DanielVorhaug/TFE4152-Project--Digital-Pixel-Sensor/README.md

TFE4152-Project: Digital Pixel Sensor

A 10bit, 100x100 pixel camera sensor. With the pixel designed in SPICE and the pixel array and supporting logic designed in SystemVerilog.

See https://github.com/wulffern/dic2021/blob/main/lectures/l6_project.md for background.
