DanielVorhaug/TFE4152-Project--Digital-Pixel-Sensor/IC_project.pdf

# A 10bit, 100×100 pixel Photosensor

Carl Thyness, Student, NTNU and Daniel Vorhaug, Student, NTNU

Abstract—A 10-bit 100×100p photosensor is described. The design consisting of two parts that are simulated seperately. One part being a single pixel with a 10-bit digital-output, simulated in SPICE. The other being the digital system, including the array of pixels, all the necessary logic for correct timings, proper readout and control of the analog part. The digital part is simulated using SystemVerilog, and is scalable to any resoulution, bit depth and output bus width.

I. INTRODUCTION
There are a number of different image sensor architectures that can be used to turn the signal on an array of photodiodes or phototransistors into a digital signal. One common method is to have one analog-to-digital converter (ADC) per column of pixels [1]. Another method, which the design discussed here uses, is a digital pixel sensor (DPS) [2], which has one ADC per pixel. Having one ADC per pixel has the advantage of avoiding column fixed-pattern noise that occurs with one ADC per column [2]. Unfortunately, as having an ADC in each pixel requires more transistor space, this could leave less space for a photodiode or phototransistor. However, using backside illumination, and using a stacked process which places the image sensors and ADCs on separate pieces of silicon that are then sandwiched together increases the usable image sensor area[3].
In this paper, we describe the design of a photosensor where the pixel-array resolution, the bit-depth of each pixel and output-bus-width is adjustable by changing a single parameter for each. The chip we will present has a resolution of 100x100 pixels, a bit depth of 10bit and an output-bus of 100bit (10 pixels). The design is based on the 2001 design by Kleinfelder, Lim, Liu and Gamal [2]. Our design mainly differs in the specifications it was made for while most of the implementation is similar if not the same. In implementation the main differences are the modularity of our chip and that we allow for less outside control of the chip. The last part will be done primarily for chip density and security. The resolution and bit depth will allow for use in more detail-demanding work.

II. THEORY
Our design will be based on the one detailed in [2]. No further knowledge is required.

III. IMPLEMENTATION
For simplicity’s sake the design has been split into two parts. An analog part consisting of a single pixel, and a digital part containing an array of a simplified model of the analog pixel and the necessary logic to read the pixel data.
A. Analog
Our analog design consist of three important subcircuits: The actual sensor, the per pixel comparator and the per pixel memory. Each playing their part in getting a digital signal from every pixel. All circuits are based on the ones detailed in [2] and specifically the models made by Carsten Wulff [4].
1) Photosensor: The photosensor consists of six transistors, one phototransistor to convert photon radiation into an electrical signal and five transistors to handle the Read/Erase logic. The circuit is as shown in figure 1.

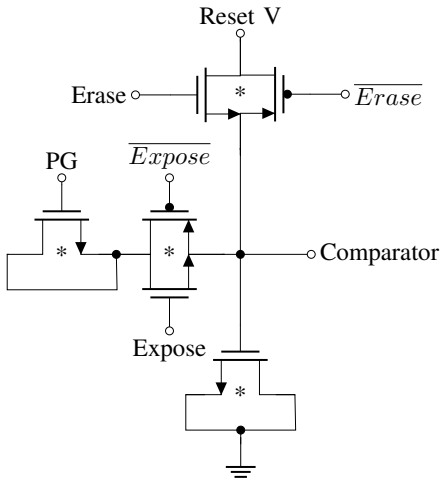
[picture p1: figure]
Reset V; Comparator; Erase; Expose

Fig. 1: Photosensor

The expose and erase transistors all have the same dimensions of w=0.5µm and l=0.15µm. The nmos are single transistors while the pmos are four transistors in parallel for as close to equal driving force as possible. We chose to model the phototransistor as a resistor and current source, while the lower transistor is used as a capacitor and we have therefore modelled it as such. When exposed a voltage will be built up over the phototransistor giving us a value dependent on the light levels hitting the pixel.

2) Comparator: The comparator is part of the per pixel ADC in our system. It is set up as a differential pair amplifier connected with two inverters. The two inverters are meant to amplify the signal from the differential pair, ensuring that even a small voltage difference flips the output completely between logical low and high. One input is the voltage from the sensor and one input is an analog ramp. The output of the comparator goes to the memory and is high when the sensor voltage is higher than the analog ramp. The circuit can be seen in figure 2.

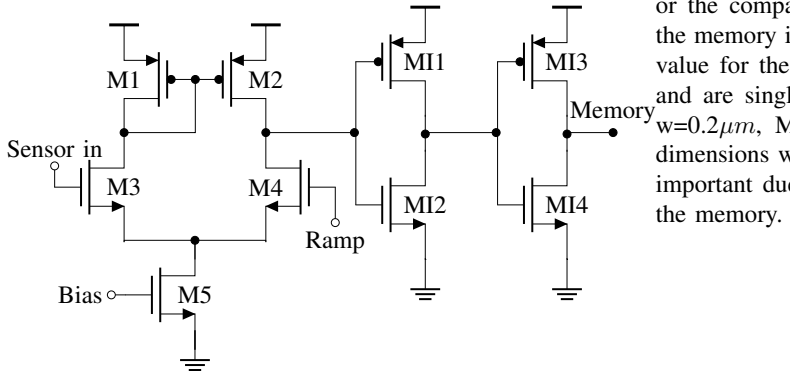
[picture p2: figure]
Bias; Ramp; Sensor in; Memory; the memory.

Fig. 2: Comparator.

The transistor M5 is part of a current mirror, allowing us to control the current passing through the comparator. We set the current through this transistor to 6µA. All transistors have the same width of 0.5µm. The transistor in current mirrors have lengths 0.5µm while the differential pair nmos and the inverter transistors all have length 0.15µm. The current mirror transistors M1, M2 and M5 are all single transistors, giving us a low ratio between width and length which again ensures that they are all in strong inversion. The differential pair transistors M3 and M4 are both two transistors in parallel. This keeps them all in weak inversion. For the inverters we made the nmos (MI2 and MI4) single transistors while the pmos (MI1 and MI3) are four in parallel. This is to ensure close to equal driving force.

3) Memory: Each pixel has a 10bit memory, each bit is held by a 3t memory cell. Each pixel therefore have 10 memory cells, giving us a total of 30 transistors for the memory of each pixel. The circuit diagram of our 3t memory cells can be seen in figure 3.

M3

M2

M1

Data I/O
Read

Comp in

Fig. 3: 3t memory cell.

When the signal from the comparator goes low the current value in each memory cell is held until it is either read out or the comparator signal goes high again. The data held in the memory is from our gray code counter, giving us a digital value for the pixel. All transistors have a length of 0.13µm and are single transistors. When it comes to width M1 has w=0.2µm, M2 has w=0.4µm and M3 has w=1µm. These dimensions were chosen to minimise the footprint, especially important due to the large amount of transistors required by

B. Digital

The digital part of the design is made in the hardware description language SystemVerilog. The sensor is split into modules shown in figure 4. The Counter counts up on the vertical buses and the pixels use this to digitize their analog readings. When this data is to be read out of the pixels, the Memory controller uses the Row pointer to tell which pixel row should be read out and uses the Output bus to put the data on a smaller bus to be written to the outside.

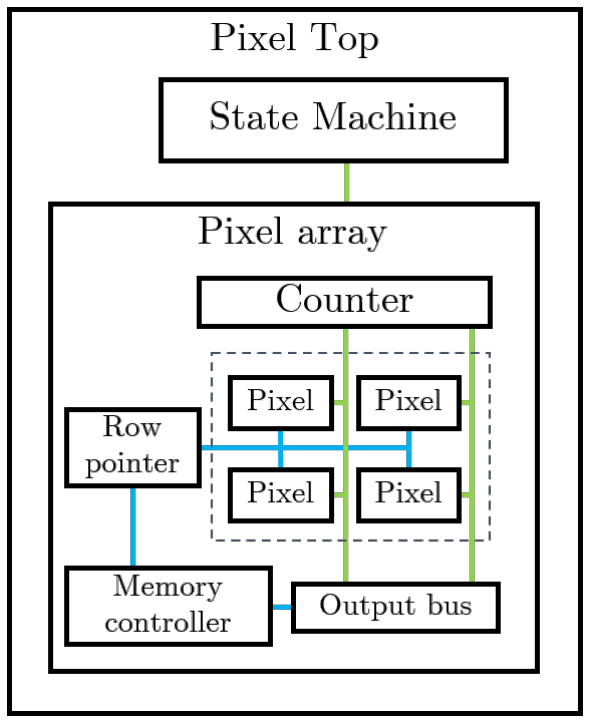
[picture p3: figure]

Fig. 4: Illustration of the modules in the SystemVerilog project and how they are connected. The pixel array in the dashed box shows for when it is compiled for a 2x2 array.

1) Pixel Top: The system interfaces with the world through the top-level modules’ inputs and outputs. The top module takes in a system clock, driving the modules’ own, and a reset signal. It outputs a data-bus and a clock. The clock signals when data is put on the bus. Size of the output-bus is configurable by changing a single parameter, but is set to 100 bit which is 10 10-bit pixels wide. Apart from this, the module only connects the state machine to the pixel array module.
2) State machine: A state machine module controls the timing of an image capture. The states and transitions are shown in figure 5. It uses a counter to time how many clock cycles it has been in each state and to keep track on when to transition to the next state. The state machine uses the rising edge of the system clock to increase a counter and check if it should transition. Then it uses the falling edge to apply the output signals the current state entails.

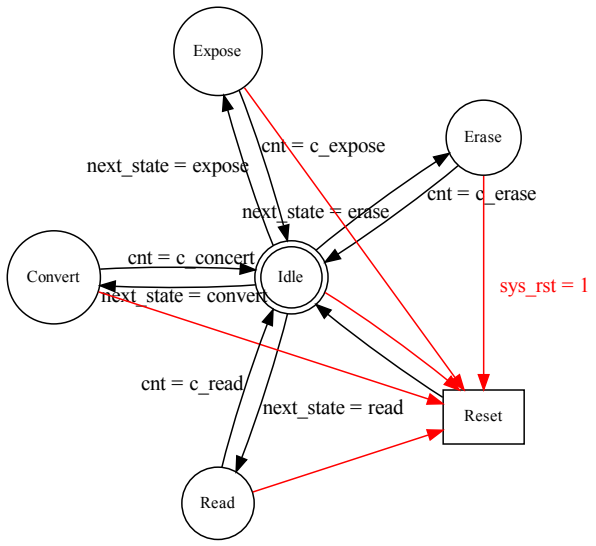
[picture p4: figure]
Idle; Erase; next_state = erase; Expose; next_state = expose; Convert; next_state = convert; Read; next_state = read; Reset; sys_rst = 1; cnt = c_erase; cnt = c_expose; cnt = c_concert; cnt = c_read

Fig. 5: State diagram of the main state machine.

3) Pixel array: The pixel array contains all the individual pixels and necessary logic to act upon the signals sent from the state machine module. In it we have each individual pixel (sorted in a grid), the counter, the memory controller, the row pointer and the output bus. The three last submodules are all used to control the output from the pixel onto the outpus bus.
4) Pixel: In Verilog we only have a model of how the actual analog pixel works. It is based on the model made by Carsten Wulff [4]. The model works by lowering the voltage value into the comparator by a constant value per clock cycle it is told to ”expose” the phototransistor. The analog ramp is modeled as a value incrementing by a constant value per clock cycle we convert the analog signal. When the analog ramp gains a higher value than the one coming from the phototransistor we set the value out of the comparator low. The memory is continuously overwritten as long as the signal from the comparator is high and locks the current value when the comparator output signal goes low. Lastly the signal out of the pixel is set to high impedance when READ is low and to the inverted of the value currently in the memory when READ is high.
5) Counter: The counter give values in Gray code. It is written as a 10 bit full adder, adding 1 on the rising edge of the system clock. The current value is then converted into Gray code and sent out. When RESET is set high the counter is set to 0.
6) Memory controller: The memory controller is a four state finite state machine. It is an updated version of the one made by Carsten Wulff [4]. The states and their transitions can be seen in figure 6.

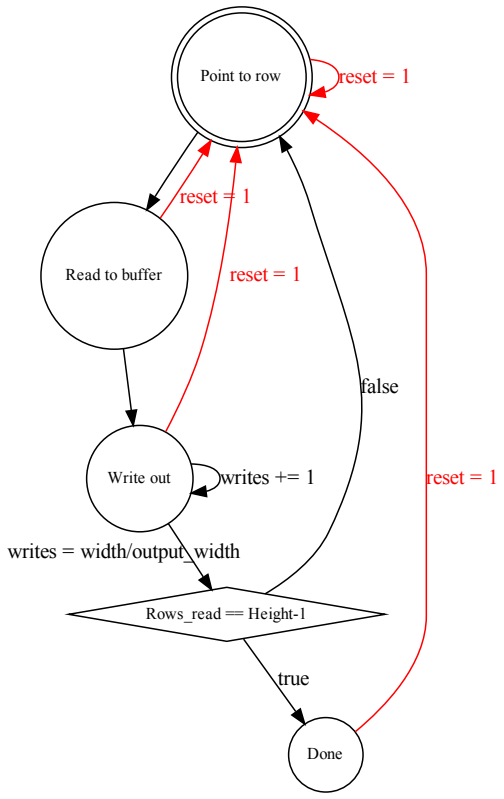
[picture p5: figure]
Point to row; reset = 1; Read to buffer; Write out; writes += 1; Rows_read == Height-1; writes = width/output_width; Done; false; true

Fig. 6: State diagram of the memory controller.

First it sends a signal to the read pointer making it have one row write its’ memory value onto the data bus. Second, during the next clock cycle, it has the output bus read this signal onto its’ buffer. Third it has the output bus read the signal out sequentially (more on this in III-B8). Then the memory controller goes through these three states until all rows have been read out. Then it finally reaches the fourth state: Done. If the memory controller ever receives a reset signal it is reverted back to the Point to row state.

7) Row pointer: The row pointer takes in a binary value from the memory controller and through shifting sends out individual signals to each pixel row.
8) Output bus: The output bus is a parallel in, series out bus. It takes all values from a row into its buffer in parallel.. Then, as the data has been inverted when read out of the pixel memory, the data is inverted back in this module. After this the data is converted from Gray code back into natural binary code. Finally it reads the data out sequentially. The bus takes in 1kbit controlled by a read clock and then writes out 100 bit each clock cycle of a write clock coming from the memory controller.

IV. RESULT

A. Analog section
1) Current: Measurements of currents through one pixel can be seen in figure 7.

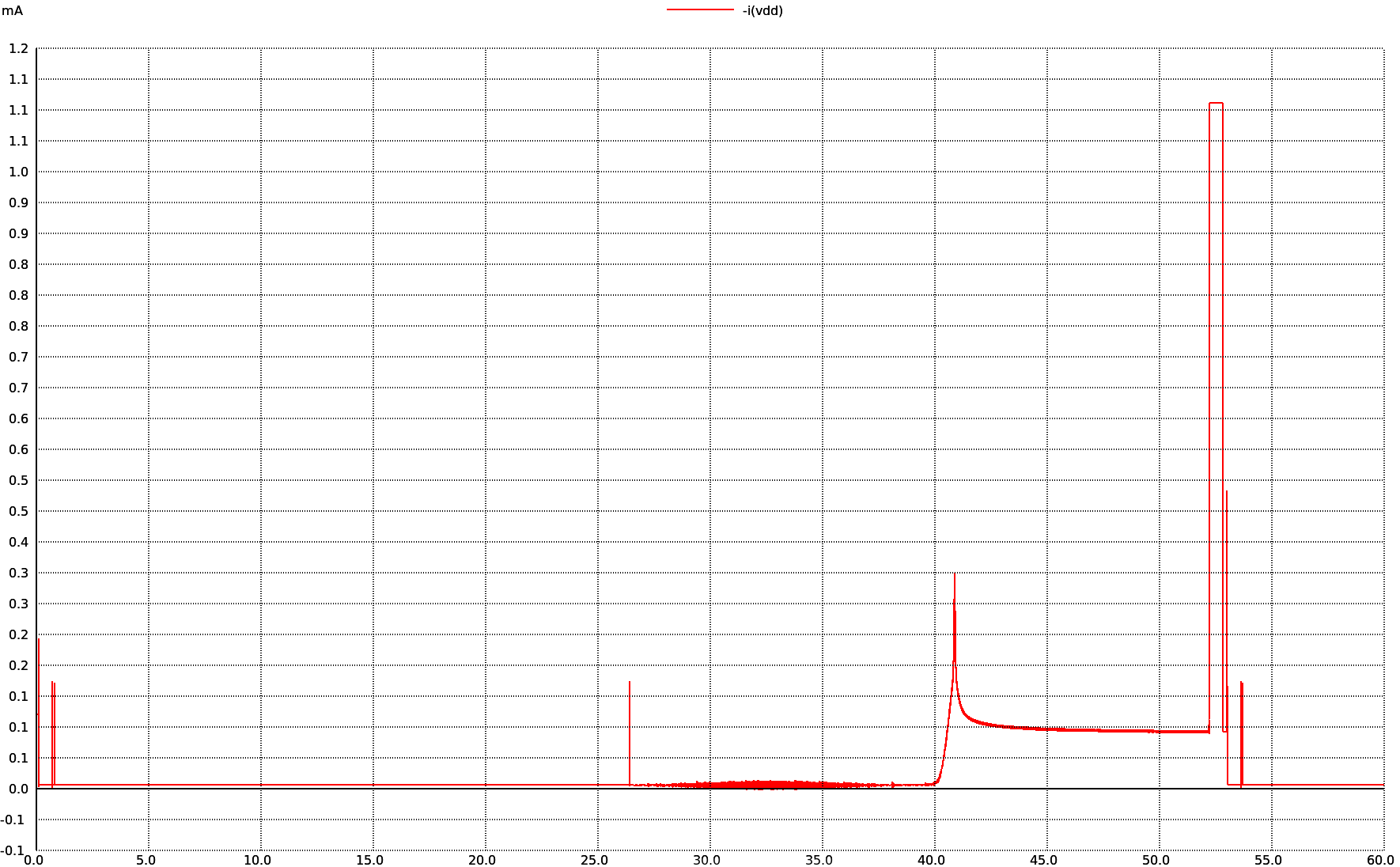
[picture p6: figure]

Fig. 7: Measured current through an individual pixel.

The current consumption varies a lot depending on the state, but most of the time there is simply an idle current, as can be seen in figure 8.

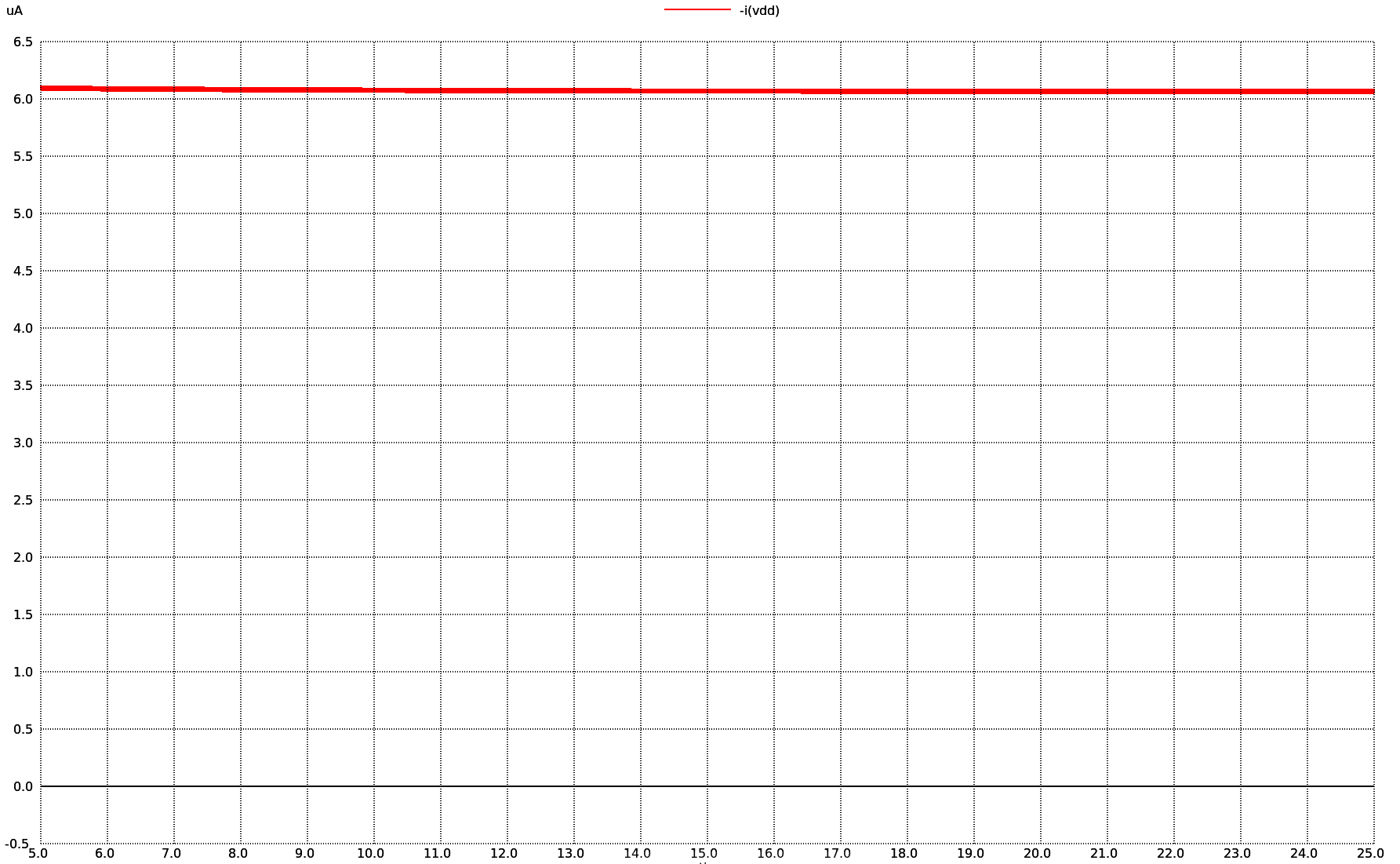
[picture p7: figure]

Fig. 8: Idle current of a single pixel.

The idle current is approximately 6µA while the peak current consumption reaches a bit above 1.1mA. That specific peak is caused by the readout of the memory. This because high bits in the memory causes a short circuit when read out, more on this in IV-A4. A 100 × 100 array would because of this have an idle current consumption of about 60mA and a peak current consumption of 11A from the pixel array, in addition to the digital logic. Other noticable peaks are:
- At 41µs, which reaches 350µA and is caused by the comparator flipping the output value.
- At the start and at 54µs, these reach up to 175µA and are caused by the erasure of former values in the memory and the begining of a new exposure process.
- At 26µs which reaches 175µA and coincides with convert going high and the analog ramp starting.
The current between 41µs and 55µs, the peaks caused by the comparator flipping and the memory being read out, is between 90 and 100 µA. The absolute peak current is dependent on the value of the pixel as the more bits that are high the more short circuits and the more current drawn.
2) Photosensor verification: The storage capacitor should be charged to Reset V= 1.1V during the erase phase. Figure 9 shows that this is the case, but that turning off the transmission gate causes a voltage jump of 12mV and 12mV
1100mV = 1.10%.

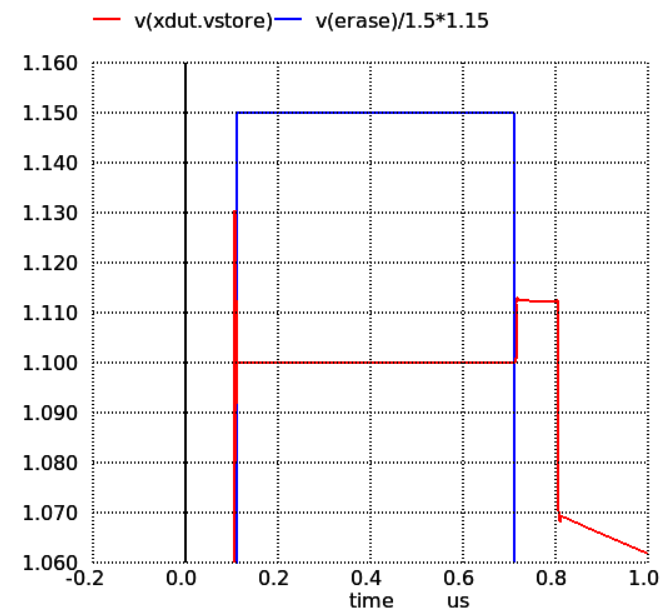
[picture p8: figure]

Fig. 9: Plot of storage capacitor voltage during the erase phase. Erase signal voltage is normalized to 1.15V.

During the expose part of taking a sample, the voltage across the storage capacitor should have time to converge. A plot of this is shown in figure 10. The figure shows voltage has almost converged, but also that turning on and off the expose transmission gate causes a ripple in the storage capacitor voltage. Turning it on causes a 40mV (

40mV
1112mV = 3.60%) drop
and turning it off again causes a 22mV (

22mV
853mV = 2.58%) rise.
When added with the jump from the erase phase these changes almost cancel each other out as 1.10% − 3.60% + 2.58% = 0.08%

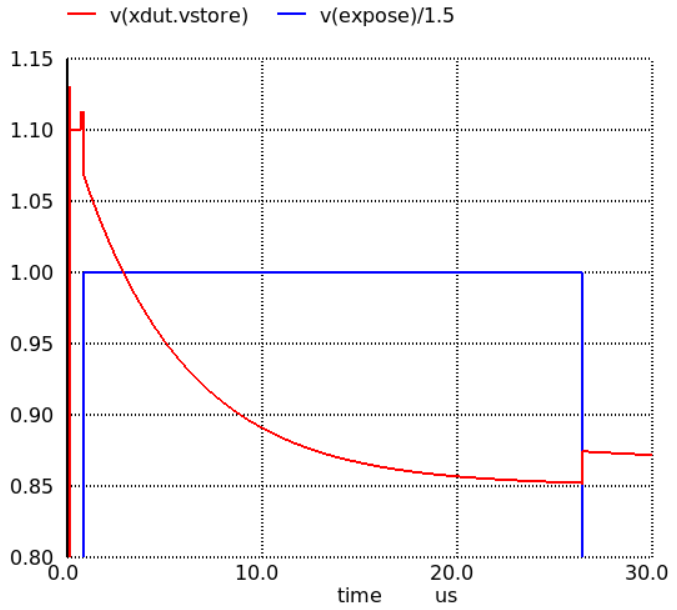
[picture p9: figure]

Fig. 10: Plot of storage capacitor voltage during the expose phase. Expose signal voltage is normalized to 1V.

The capacitor should also hold its charge during the convert phase. The plot in figure 11 indicates that the voltage falls by 875.0mV − 856.5mV = 18.5mV and 18.5mV
875.0mV = 2.1%.

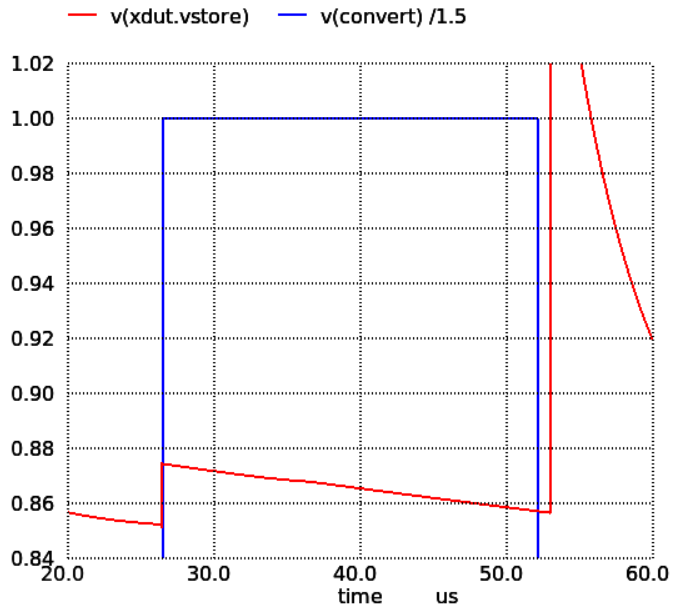
[picture p10: figure]

Fig. 11: Plot of storage capacitor voltage during the convert phase. Expose signal voltage is normalized to 1V.

3) Comparator delay: The comparator delay is measured from the time the sensor in voltage and the ramp voltage from figure 2 are equal, until the Comp in input on the memory from figure 3 has become low. Comp in is defined as low when it is 10% of the logic voltage 0.1 · 1.5V = 0.15V . A plot of ramp crossing sensor in is shown in figure 12 and Comp in reacting in figure 13. This shows that the comparator delay is 37.16µs − 36.96µs = 0.2µs.

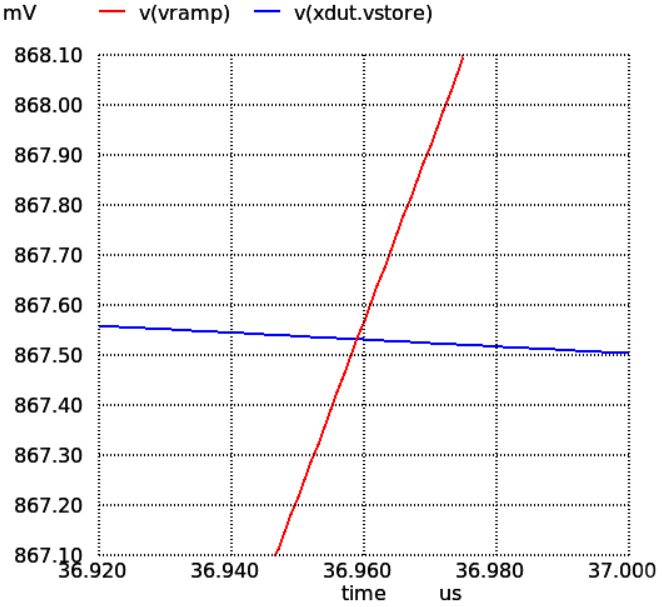
[picture p11: figure]

Fig. 12: Plot of ramp (vramp) crossing sensor in (vstore).

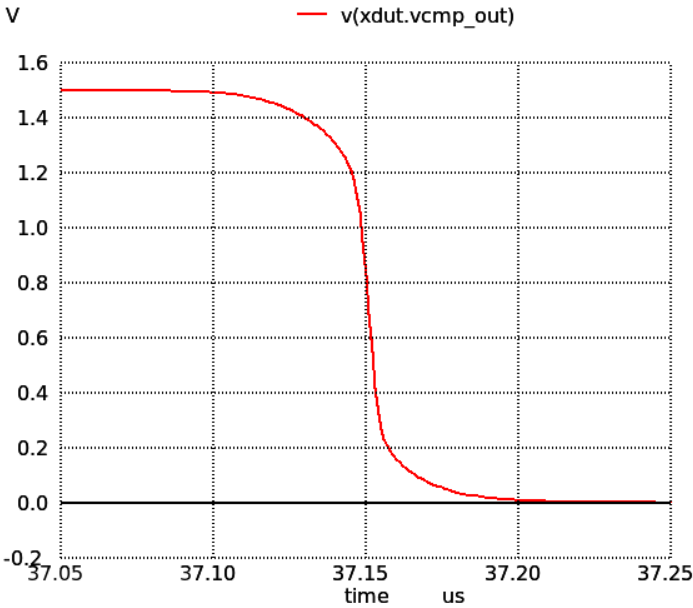
[picture p12: figure]

Fig. 13: Plot of Comp in (vcmp out) going low after ramp crosses sensor in.

4) Digital value gets stored in memory: The memory needs to store the current data when the signal from the comparator goes low. Figure 14 demonstrates that the value in the memory is kept when the comparator triggers.

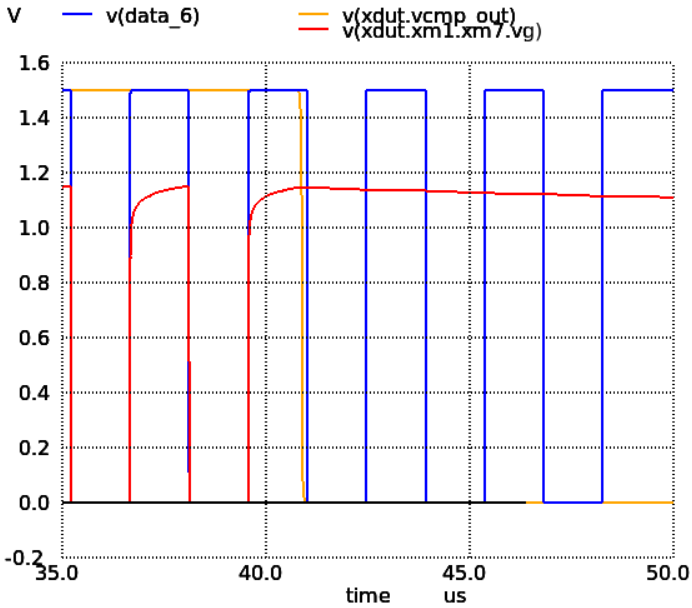
[picture p13: figure]

Fig. 14: Plot of a cell of memory when the comparator signal vcomp out goes low. vg is data stored in the memory and data 6 is the data in- and output.

When the read signal is set high, the data in the memory cells should be output. The memory is inverting, so if a high value is stored, the output will be low and vice versa. This process creates a short circuit when the stored value is high. Figure 15 shows that a high stored bit leads to a low output signal when read is high, and Figure 16 shows that a low stored bit leads to a high output signal when read is high.

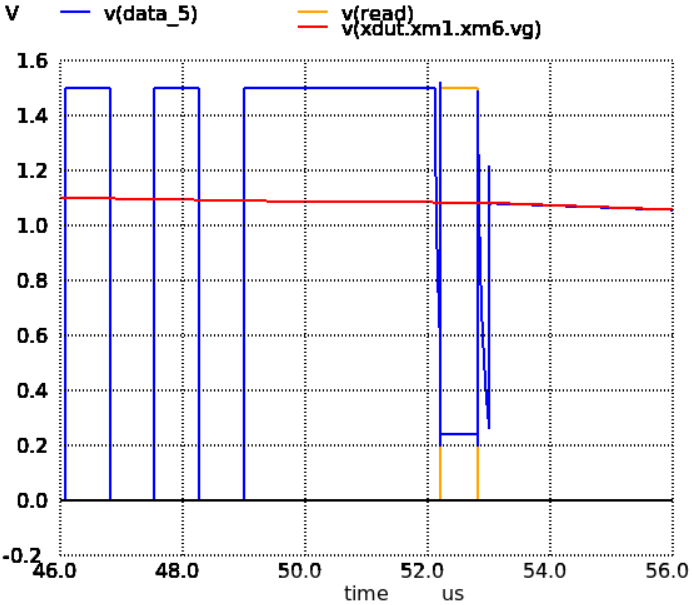
[picture p14: figure]

Fig. 15: Plot of a cell of memory when the read signal read goes high. vg is data stored in the memory and data 5 is the data in- and output.

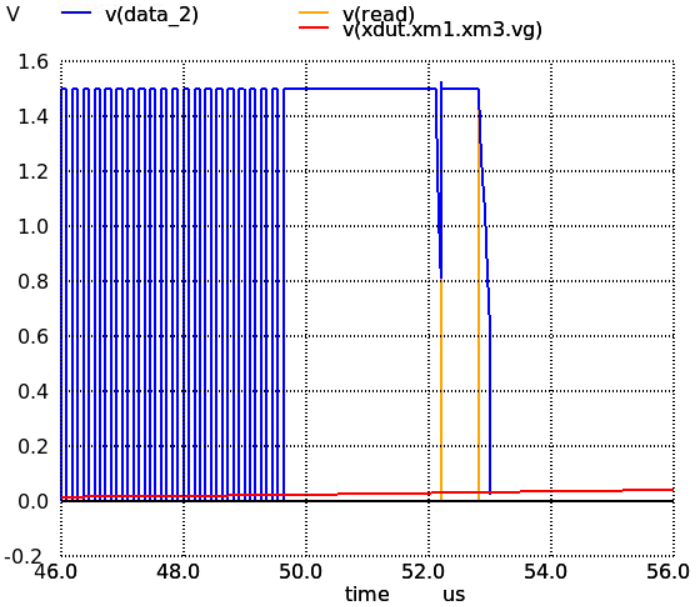
[picture p15: figure]

Fig. 16: Plot of a cell of memory when the read signal read goes high. vg is data stored in the memory and data 2 is the data in- and output.

The sensor needs to work in the whole range of the ADC. Figure 17 shows a sample with a low current source in the photodiode model and 18 with a high current. All the phases of the sample cycle works as they should.

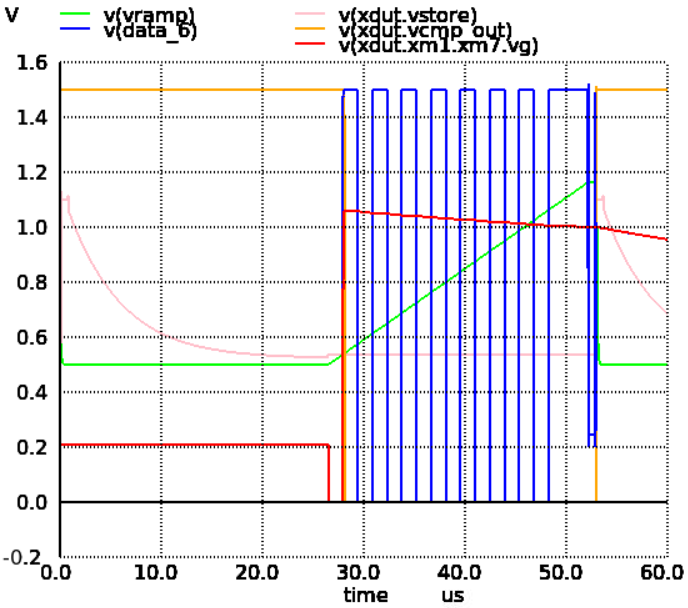
[picture p16: figure]

Fig. 17: One sample cycle with little light on the photodiode. vg is data stored in the memory, data 6 is the data in- and output, vstore is the storage capacitor voltage, vramp is the ramp and vcmp out is the output from the comparator.

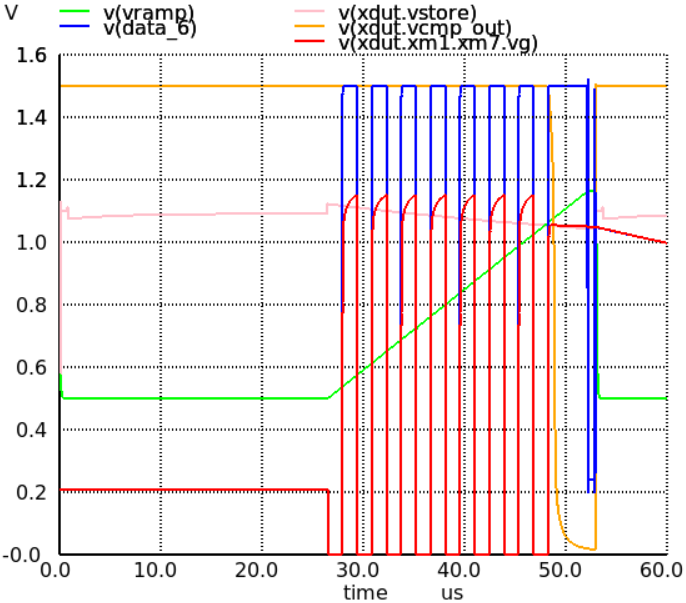
[picture p17: figure]

Fig. 18: One sample cycle with much light on the photodiode. vg is data stored in the memory, data 6 is the data in- and output, vstore is the storage capacitor voltage, vramp is the ramp and vcmp out is the output from the comparator.

B. Digital section
All modules that are a part of the digital section have its own test bench to determine that they work as intended. The test bench for Pixel Top tests the entire system.
Throughout the digital results we will show timing dia-grams, some of these have been colour coded. Dark blue mean it is an input into the submodule, yellow means it is a clock, cyan means it is an internal signal only affecting the submodule, green means it is an output signal and purple signals denotes the current state of a state machine.
1) Pixel: The testbench for the pixel needs to show that it can do a sample cycle. As the pixel module is a simplified model of the analog pixel, it needs to behave as the pixel it represents. A state machine is used to cycle through the procedure of making a sample:
0 Erasing the pixel

1 Exposing/integrating the pixel
2 Converting the stored analog value into a digital value
3 Reading out the digital value
The testbench needs to verify that these phases are executed as they should on one individual pixel. Figure 19 shows that
step 0, erasing, works. This and the following tests of the pixel are configured with a bit depth of 8 bits.

Fig. 19: Plot showing the effect on the ERASE signal going high. p data is the pixel memory, adc is the analog ramp and tmp is the model of the storage capacitor voltage. All of them are successfully reset to their original value.

A successful step 1, exposing, is shown in figure 20.

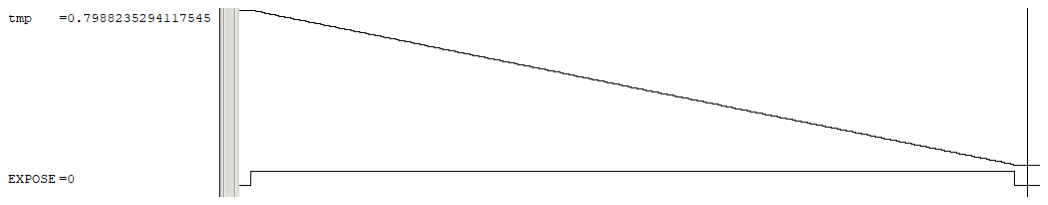
[picture p18: figure]

Fig. 20: The expose phase. tmp is the model of the storage capacitor voltage

Step 2, converting, is plotted in figure 21. The output from the comparator cmp goes low when adc and tmp and the data in the memory p data at that moment is kept.

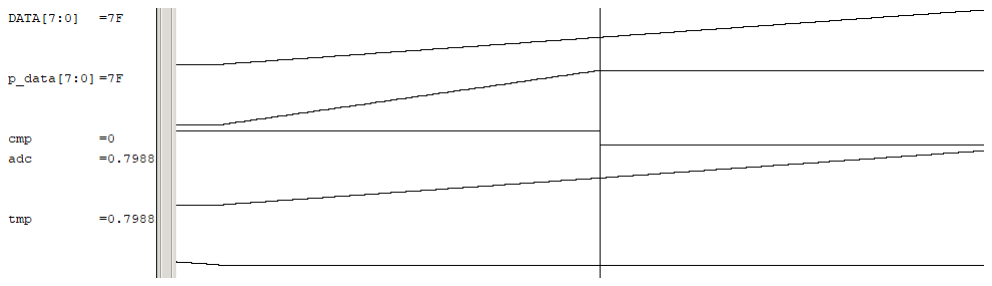
[picture p19: figure]

Fig. 21: DATA is the in- and output of the pixel, p data is the pixel memory, cmp is the output from the comparator, adc is the analog ramp and tmp is the model of the storage capacitor voltage.

A step 3, readout, is shown in figure 22. The memory successfully puts its contents p data inverted on the bus DATA when READ goes high.

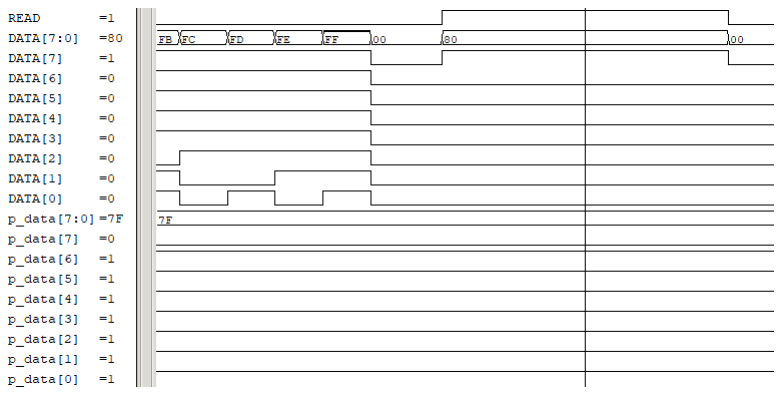
[picture p20: figure]

Fig. 22: READ is the read signal to the memory to put its content on the bus, DATA is the in- and output of the pixel and p data is the pixel memory.

2) Counter: The counter module test bench runs a clock to make the counter run through its length and the reset signal is triggered to verify that it works properly. Figure 23 shows the reaction from the counter when a reset is triggered. The internal counter value returns to 0, and so does the output the following clock cycle.

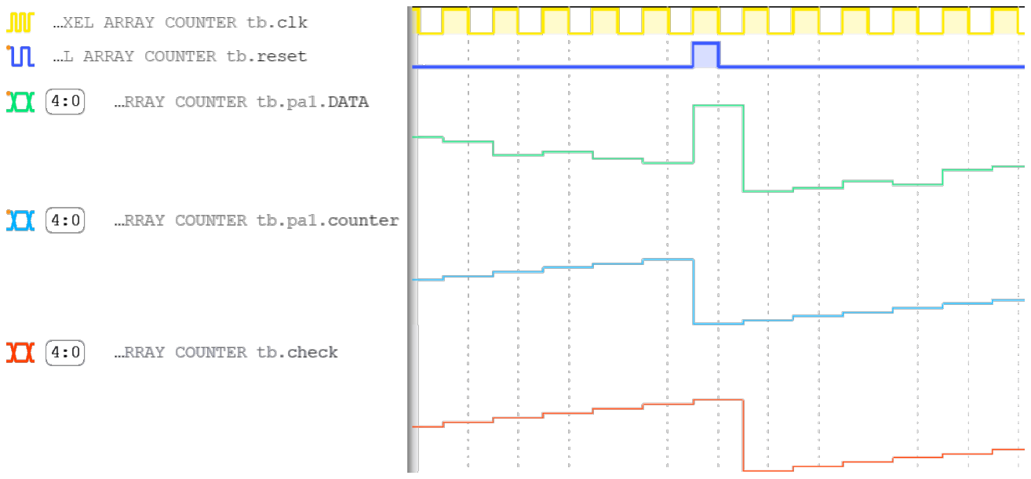
[picture p21: figure]

Fig. 23: Test results from the counter test bench. The figure is from a test with a bit depth of 5-bit to make the plots clearer. The plot ”DATA” is the gray-coded number outputed from the counter module, the plot ”counter” is the value of the counter before being gray-coded and the bottom plot ”check” is the gray-coded number transformed back into a regular number by the test bench.

A Gray-decoder is used in the test bench to verify that the Gray-coder in the counter works. The output of the counter module is one clock cycle behind the binary counter inside it. If the Gray-coder works, the decoded signal should be the same as the one from the counter, but one cycle behind. Figure 24 shows a part of a test-log where this is the case, which indicates the Gray counter works.

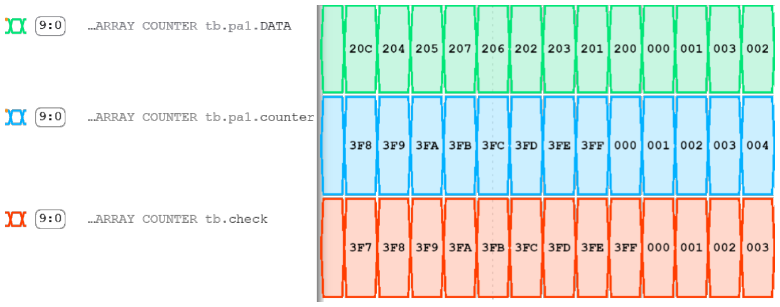
[picture p22: figure]

Fig. 24: Test results from the counter test bench. The top plot ”DATA” is the Gray-coded number outputed from the counter module, the middle plot ”counter” is the value of the counter before being Gray-coded and the bottom plot ”check” is the gray-coded number transformed back into a regular number by the test bench.

3) Memory Controller: For the purpose of having the results be presentable we will show a test of the memory controller where the parameters were quite different than in the full system. In this test the pixel height was set to 9, the width to 8 and the output bus was 40 bit, with other words 4 pixels, wide. The memory controller works as a state machine going through the following states:
0 Point to row
1 Read to buffer

2 Write out
3 Done
The test had the memory controller go through the states as if it controlled the write out of 8x9 pixel array through a 4 pixel wide output bus, but we will only show it process the last three rows. The results can be seen in figure 25.

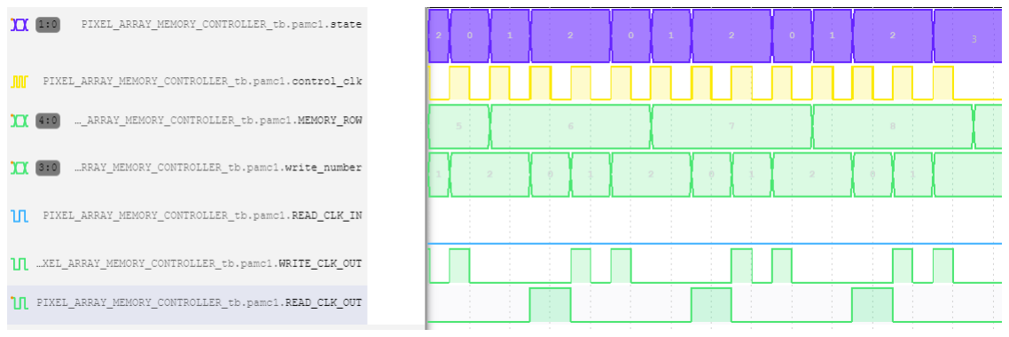
[picture p23: figure]

Fig. 25: Test of the memory controller. Showing readout of last three rows.

As can be seen in 25 the memory controller moves through all states. Using one cycle on the point to row, one cycle on read to buffer and two cycles on write out. It takes two cycles to read out as it can only read out 4 pixels per cycle and the chip had a width of 8 pixels. The memory controller sends out one pulse on read clk out and two pulses on write clk out. These pulses are used by the output bus to read into its’ buffer and then write the data out. For results from the full test see 31.
4) Row pointer: The row pointer takes in a control signal and uses bit shifting to send a read to one specific row. When it gets in 0 that means the first row should be read and when it gets in 5 that means the sixth row should be read. For presenting purposes the test shown will have the height set to 9 pixels. The results can be seen in figure 26.

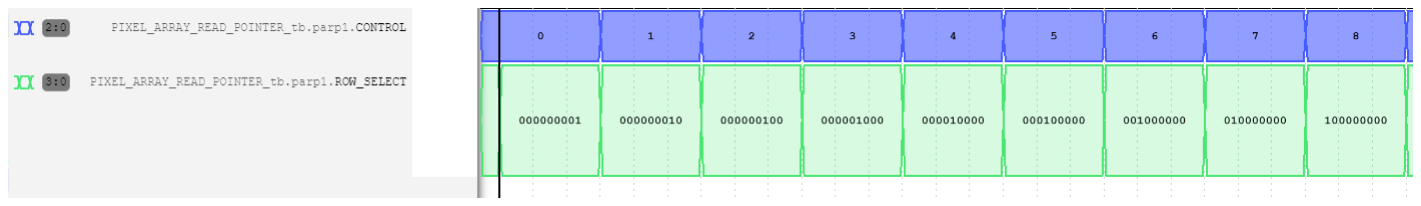
[picture p24: figure]

Fig. 26: Test of the row pointer

As can be seen, the row pointer sends out a row of 0’s with only a singular 1 in it. The position of the 1 is controlled by the control signal and as such the test is a success.
5) Output bus: The output bus takes in data from the pixels, inverts it back, converts it back from Gray code and writes it out. When it does this is dependent on the memory controller. One write out of a system with width 8, bit depth 10 and a bus width of 40bit can be seen in figure 27.

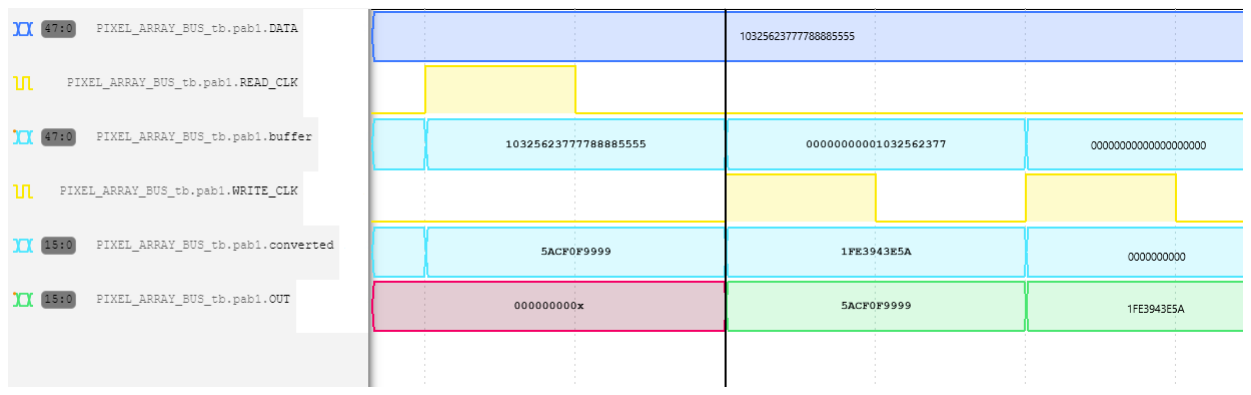
[picture p25: figure]

Fig. 27: Test of the output bus in a system with width 8, bit depth 10 and bus width 40bit.

As can be seen from the results the output bus only takes in signals and read them out when it gets the appropriate signals from the memory controller, namely read clk and write clk. It also converts the gray code correctly back into common binary values.
6) State machine: The state machine controlls the pixel array by sending signals to tell it what to do. The state machine iterates through 5 different states for this purpose:
0) Erase
1) Expose
2) Convert
3) Read
4) Idle
The states last vastly different duration’s and as such it is quite difficult to present in a nice manner. Therefore the test we will show has altered duration’s for each state except Idle. We set the duration of erase to 10 cycles, expose to 11 cycles, convert to 9 cycles and read to 12 cycles. Idle was kept at 1 cycle. The results can be seen in figure 28.

Fig. 28: Test of the state machine with the duration of each state altered.

In 28 it is also shown the counter that keeps track of how long the state machine has been in each state. As we can see the state machine switches states after the correct amount of cycles.
7) Pixel top: As all subsystems have been tested and verified we will here only concern ourselves with the most important factors. That means we will only look at the current state, the data line within the pixel array and the output. The results from a simulation at full resolution can be seen in figure 29.

Fig. 29: Results from pixel top test.

As the results include thousands of clock cycles a lot details are hard to discern. The full VCD file from the simulation can be found in appendix C. For a more informative view we can zoom in on the write out. For this see figure 30.

Fig. 30: Results from pixel top test, zoomed in on write out.

Here we can see that the data is properly converted and written out. As all pixels are exposed for the same amount of time and modelled with the exact same parameters they all give out the same value.

V. DISCUSSION
As a whole our results are promising. A 0.2µs delay through the comparator means that we can ensure that all values are correct plus minus one quantization with a frequency as high as 5MHz. Furthermore the gray code counter ensures only minimal issues can be caused by timing errors elsewhere on the chip. The 10 bit pixel depth and resolution ensures a good quality picture and at potentially high frame rates, if the frequency can be delivered upon. Two main issues with our chip is the high transistor count, which can limit the pixel density, and high current consumption. The comparator, the main continuous current drain, uses 6µA. Meaning our 100x100p chip uses about 60mA even when in standby. And the peak current of 11A would fry the chip in its current state. Lastly we have not synthesised and routed anything, meaning we have little to no knowledge on how parasitic effects would alter our results.

VI. FUTURE WORK
- Tightening the current budget.
- Limiting the current when reading out of the on-pixel memory.
- Reduce transistor count and transistor size.
- Reducing comparator delay.
- Reducing the charge loss from the storage capacitor during the convert phase.
- Removal of waste cycles.
There are a number of places where it could be possible to limit the amount of cycles used.
– Removing the idle state from active use.
Could be unnecessary to spend one cycle here for every state change.
– Minimising exposure time to only what is necessary. – Combining the point to row and read to buffer actions into one state.
If all systems were validated to have this not cause timing issues.
- Improving the DAC.
Could be possible to make either a more accu-rate or smaller digital to analog converter, all depending on the purpose and requirements.
- Have the output work by its’ own clock. Could allow for faster write speeds.
- Synthesis and routing.

VII. CONCLUSION
We have designed and detailed a 100×100 pixel photosensor utilising a per pixel ADC. Timings have been kept tight and the clock frequency could theoretically go as high as 5MHz with only minor issues. The standby current draw of the chip was about 60mA, but with a peak current consumption of about 11A. The transistor count was also quite high, incuring costs and limiting pixel density. The design was split into two parts, one analog and one digital. The digital system was detailed and simulated in systemVerilog, the analog system in SPICE. The analog system went into detail on the individual pixel while the digital system described the composition of the pixels and the logic used to get data out of the pixels in a systematic manner. The digital system was made to be modular with respect to resolution, bit depth and output bus width.

VIII. APPENDIX

APPENDIX A
GITHUB REPOSITORY
https://github.com/DanielVorhaug/TFE4152-Project– Digital-Pixel-Sensor (https://github.com/DanielVorhaug/TFE4152-Project--Digital-Pixel-Sensor)

APPENDIX B
FULL MEMORY CONTROLLER TEST

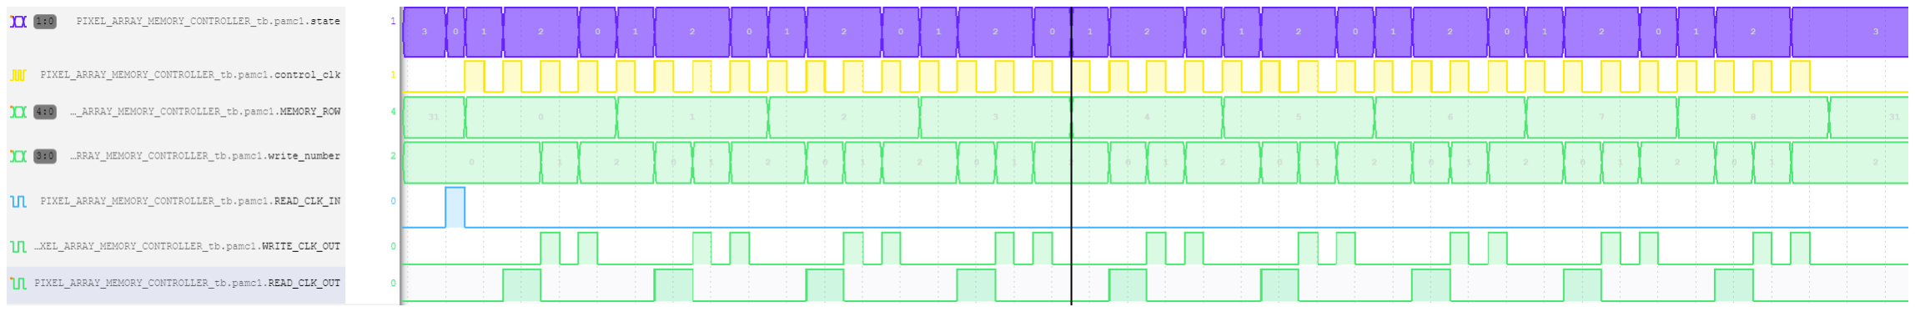
[picture p26: figure]

Fig. 31: Test of the memory controller, width of 8, height of 9, bit depth of 10 and output bus size of 40 bit.

APPENDIX C
VCD FILE FROM FULL RESOLUTION PIXEL TOP TEST
Note: In this file the frequency has been arbitrarily set to 20GHz. As the simulation only deals in logic, with no rise or fall times, the frequency could have been set to anything and it would not matter. The file can be downloaded here. (https://studntnu-my.sharepoint.com/:u:/g/personal/danievo_ntnu_no/EeqCac_eA2lMrXp7BK8cXn4BSle86RLHUHV6Vb38Xuez5g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)

APPENDIX D
SPICE: PIXELSENSOR.CIR

1
2* Pixel sensor
3**
4** | Copyright (c) 2021 Carsten Wulff Software, Norway
5**
6** Created | : wulff at 2021-7-22
7**
8** The MIT License (MIT)
9**
10** Permission is hereby granted, free of charge, to any person obtaining a copy
11** of this software and associated documentation files ( the "Software"), to deal
12** in the Software without restriction, including without limitation the rights
13** to use, copy, modify, merge, publish, distribute, sublicense, and/or sell
14** copies of the Software, and to permit persons to whom the Software is
15** furnished to do so, subject to the following conditions :
16**
17** The above copyright notice and this permission notice shall be included in all
18** copies or substantial portions of the Software. 19**
20** THE SOFTWARE IS PROVIDED "AS IS", WITHOUT WARRANTY OF ANY KIND, EXPRESS OR
21** IMPLIED, INCLUDING BUT NOT LIMITED TO THE WARRANTIES OF MERCHANTABILITY,
22** FITNESS FOR A PARTICULAR PURPOSE AND NONINFRINGEMENT. IN NO EVENT SHALL THE
23** AUTHORS OR COPYRIGHT HOLDERS BE LIABLE FOR ANY CLAIM, DAMAGES OR OTHER
24** LIABILITY, WHETHER IN AN ACTION OF CONTRACT, TORT OR OTHERWISE, ARISING FROM,
25** OUT OF OR IN CONNECTION WITH THE SOFTWARE OR THE USE OR OTHER DEALINGS IN THE

26** SOFTWARE.
27**
28**
29
30.SUBCKT PIXEL_SENSOR VBN1 VRAMP VRESET ERASE EXPOSE READ 31+ DATA_9 DATA_8 DATA_7 DATA_6 DATA_5 DATA_4 DATA_3 DATA_2 DATA_1 DATA_0 VDD VSS
32
33
34XS1 VRESET VSTORE ERASE EXPOSE VDD VSS SENSOR 35
36XC1 VCMP_OUT VSTORE VRAMP VDD VSS COMP
37
38XM1 READ VCMP_OUT DATA_9 DATA_8 DATA_7 DATA_6 DATA_5 DATA_4 DATA_3 DATA_2 DATA_1 DATA_0 VDD VSS MEMORY
39
40.ENDS
41
42.SUBCKT MEMORY READ VCMP_OUT
43+ DATA_9 DATA_8 DATA_7 DATA_6 DATA_5 DATA_4 DATA_3 DATA_2 DATA_1 DATA_0 VDD VSS
44
45XM1 VCMP_OUT DATA_0 READ VSS MEMCELL
46XM2 VCMP_OUT DATA_1 READ VSS MEMCELL 47XM3 VCMP_OUT DATA_2 READ VSS MEMCELL 48XM4 VCMP_OUT DATA_3 READ VSS MEMCELL 49XM5 VCMP_OUT DATA_4 READ VSS MEMCELL 50XM6 VCMP_OUT DATA_5 READ VSS MEMCELL 51XM7 VCMP_OUT DATA_6 READ VSS MEMCELL 52XM8 VCMP_OUT DATA_7 READ VSS MEMCELL 53XM9 VCMP_OUT DATA_8 READ VSS MEMCELL 54XM10 VCMP_OUT DATA_9 READ VSS MEMCELL
55
56.ENDS
57
58.SUBCKT MEMCELL CMP DATA READ VSS
59M1 VG CMP DATA VSS nmos | w=0.2u | l=0.13u
60M2 DATA READ DMEM VSS nmos | w=0.4u | l=0.13u
61M3 DMEM VG VSS VSS nmos | w=1u | l=0.13u
62C1 VG VSS 1p
63.ENDS
64
65.SUBCKT SENSOR VRESET VSTORE ERASE EXPOSE VDD VSS
66
67* Capacitor to model gate-source capacitance 68C1 VSTORE VSS 100f
69Rleak VSTORE VSS 100T
70
71* Switch to reset voltage on capacitor
72MnReset VRESET ERASE VSTORE VSS nmos w=0.5u l=0.15u 73XI1 ERASE ERASE_N VDD VSS INVERTER
74MpReset VRESET ERASE_N VSTORE VDD pmos w=0.5u l=0.15u m=4 75*Might want to drop m = 4 on the pmos
76
77* Switch to expose pixel
78MnExpose VPG EXPOSE VSTORE VSS nmos w=0.5u l=0.15u 79XI2 EXPOSE EXPOSE_N VDD VSS INVERTER
80MpExpose VPG EXPOSE_N VSTORE VDD pmos w=0.5u l=0.15u m=4 81
82* Model photocurrent
83* Set current source between 10n and 22n
84* to test different light levels 85Iphoto VSS VPG dc 17n
86Rphoto VPG VSS 50Meg
87.ENDS
88
89.SUBCKT COMP VCMP_OUT VSTORE VRAMP VDD VSS 90
91
92mp1 VP VP VDD VDD pmos w=0.5u l=0.5u
93mp2 VO VP VDD VDD pmos w=0.5u l=0.5u
94
95mn1 VP VSTORE VS VS nmos w=0.5u l=0.15u m=2 96mn2 VO VRAMP VS VS nmos w=0.5u l=0.15u m=2
97
98I3 0 VBN1 dc 6u
99*This is just making a current mirror out of the lowest transistor
100mb1 VBN1 VBN1 VSS VSS nmos w=0.5u l=0.5u
101mb2 VS VBN1 VSS VSS nmos w=0.5u l=0.5u
102
103*INVERTER
104mp3 VO2 VO VDD VDD pmos w=0.5u l=0.15u m=4 105mn3 VO2 VO VSS VSS nmos w=0.5u l=0.15u

107*INVERTER

108mp4 VCMP_OUT VO2 VDD VDD pmos w=0.5u l=0.15u m=4 109mn4 VCMP_OUT VO2 VSS VSS nmos w=0.5u l=0.15u 110
111
112
113.ENDS
114
115.SUBCKT INVERTER VIN VOUT VDD VSS
116M1 VOUT VIN VDD VDD pmos w=0.5u l=0.15u m=4 117M2 VOUT VIN VSS VSS nmos w=0.5u l=0.15u 118.ENDS

APPENDIX E
SYSTEMVERILOG: PIXELTOP.V

1
2module PIXEL_TOP (
3 | input | logic SYSTEM_CLK,
4 | input | logic SYSTEM_RESET,
5 | output logic DATA_OUT_CLK,
6 | output logic [OUTPUT_BUS_PIXEL_WIDTH*BIT_DEPTH-1:0]
DATA_OUT
7);
8 | parameter WIDTH = 100;
9 | parameter HEIGHT = 100;
10 | parameter OUTPUT_BUS_PIXEL_WIDTH = 10;
11 | parameter BIT_DEPTH = 10;
12
13 | logic power_enable;
14 | logic write_enable;
15 | logic counter_reset;
16 | logic counter_clock;
17 | real | analog_ramp;
18 | logic reset;
19 | logic erase;
20 | logic expose;
21 | logic read_reset;
22 | logic read_clk_in;
23 | logic vbn1;
24
25 | PIXEL_STATE_MACHINE #(
26 | .WIDTH(WIDTH),
27 | .HEIGHT(HEIGHT),
28 | .OUTPUT_BUS_PIXEL_WIDTH(OUTPUT_BUS_PIXEL_WIDTH)
,
29 | .BIT_DEPTH(BIT_DEPTH))
30 | pstate(
31 | .SYSTEM_CLK (SYSTEM_CLK),
32 | .SYSTEM_RESET (SYSTEM_RESET),
33 | .POWER_ENABLE (power_enable),
34 | .WRITE_ENABLE (write_enable),
35 | .COUNTER_RESET (counter_reset),
36 | .COUNTER_CLOCK (counter_clock),
37 | .ANALOG_RAMP (analog_ramp),
38 | .RESET (reset), | // Reset
voltage in paper
39 | .ERASE (erase), | // Pixel
reset in paper
40 | .EXPOSE (expose), | // PG in
paper
41 | .READ_RESET (read_reset),
42 | .READ_CLK_IN (read_clk_in),
43 | .VBN1 (vbn1) | //
ana_bias1
44 );
45
46 | PIXEL_ARRAY #(
47 | .WIDTH(WIDTH),
48 | .HEIGHT(HEIGHT),
49 | .OUTPUT_BUS_PIXEL_WIDTH(OUTPUT_BUS_PIXEL_WIDTH)
,
50 | .BIT_DEPTH(BIT_DEPTH))
51 | pa1(
52 | .POWER_ENABLE (power_enable),
53 | .WRITE_ENABLE (write_enable),
54 | .COUNTER_RESET (counter_reset),
55 | .COUNTER_CLOCK (counter_clock),
56 | .ANALOG_RAMP (counter_clock),
57 | .RESET (reset),
58 | .ERASE (erase),
59 | .EXPOSE (expose),
60 | .SYSTEM_CLK (SYSTEM_CLK),
61 | .READ_RESET (read_reset),
62 | .READ_CLK_IN (read_clk_in),
63 | .VBN1 (vbn1),
64 | .DATA_OUT_CLK (DATA_OUT_CLK),
65 | .DATA_OUT (DATA_OUT)
66 | );
67
68endmodule

APPENDIX F
SYSTEMVERILOG: PIXELSTATE.V

1
2//
3// | Copyright (c) 2021 Carsten Wulff Software, Norway
4//
5// Created | : wulff at 2021-7-21
6//
7// The MIT License (MIT)
8//
9// | Permission is hereby granted, free of charge, to any
| person obtaining a copy
10// | of this software and associated documentation files (
the "Software"), to deal
11// | in the Software without restriction, including without
| limitation the rights
12// | to use, copy, modify, merge, publish, distribute,
| sublicense, and/or sell
13// | copies of the Software, and to permit persons to whom
| the Software is
14// | furnished to do so, subject to the following conditions
| :
15//
16// The above copyright notice and this permission notice shall be included in all
17// copies or substantial portions of the Software. 18//
19// | THE SOFTWARE IS PROVIDED "AS IS", WITHOUT WARRANTY OF
| ANY KIND, EXPRESS OR
20// | IMPLIED, INCLUDING BUT NOT LIMITED TO THE WARRANTIES OF
| MERCHANTABILITY,
21// | FITNESS FOR A PARTICULAR PURPOSE AND NONINFRINGEMENT.
| IN NO EVENT SHALL THE
22// | AUTHORS OR COPYRIGHT HOLDERS BE LIABLE FOR ANY CLAIM,
| DAMAGES OR OTHER
23// | LIABILITY, WHETHER IN AN ACTION OF CONTRACT, TORT OR
OTHERWISE, ARISING FROM,
24// | OUT OF OR IN CONNECTION WITH THE SOFTWARE OR THE USE OR
| OTHER DEALINGS IN THE
25// | SOFTWARE.
26//
27//
28
29module PIXEL_STATE_MACHINE (
30 | input | logic SYSTEM_CLK,
31 | input | logic SYSTEM_RESET,
32 | output logic POWER_ENABLE = 0,
33 | output logic WRITE_ENABLE = 0,
34 | output logic COUNTER_RESET = 0,
35 | output logic COUNTER_CLOCK,
36 | output real | ANALOG_RAMP,
37 | output logic RESET = 0, | | // Reset voltage in
| paper
38 | output logic ERASE = 0, | | // Pixel reset in
| paper
39 | output logic EXPOSE = 0, | | // PG in paper
40 | output logic READ_RESET = 0,
41 | output logic READ_CLK_IN = 0,
42 | output logic VBN1 | | // ana_bias1
43);
44
45 | parameter WIDTH = 2;
46 | parameter HEIGHT = 2;
47 | parameter OUTPUT_BUS_PIXEL_WIDTH = 2;
48 | parameter BIT_DEPTH = 10;
49
50 | parameter real dv_pixel = 0.5; | //Set the expected
photodiode current (0-1)
51
52
53 | assign COUNTER_CLOCK | = ANALOG_RAMP;
54 | assign ANALOG_RAMP | = convert ? SYSTEM_CLK : 0;
55 | assign VBN1 | = EXPOSE | ? SYSTEM_CLK : 0; //
Amount of posedges decides how low photodiode
| voltage is

57 | //
58 | // State Machine
59 | //
60 | parameter STATE_ERASE=0, STATE_EXPOSE=1, STATE_CONVERT
=2, STATE_READ=3, STATE_IDLE=4;
61
62 | //State duration in clock cycles
63 | parameter integer c_erase | = 5;
64 | parameter integer c_expose | = 2**BIT_DEPTH - 1;
65 | parameter integer c_convert = 2**BIT_DEPTH - 1;
66 | parameter integer c_read | = (2+WIDTH/
OUTPUT_BUS_PIXEL_WIDTH)*HEIGHT + 1;
67
68 | parameter integer counter_max = (c_erase > c_expose ?
c_erase : c_expose) > (c_convert > c_read ? c_convert : c_read) ? (c_erase > c_expose ? c_erase : c_expose) : (c_convert > c_read ? c_convert : c_read); // Finds which state duration is longest
69
70 | logic [$clog2(counter_max)-1:0] counter;
// Delay counter in state machine, Assumes the longest state will be read
71 | logic | convert = 0;
72 | logic | convert_stop;
73 | logic [2:0] | state, next_state;
| // States
74
75
76 | // Control the output signals
77 | always_ff @(negedge SYSTEM_CLK ) begin
78 | case(state)
79 | STATE_ERASE: begin
80 | POWER_ENABLE | <= 0;
81 | WRITE_ENABLE | <= 0;
82 | COUNTER_RESET | <= 1;
83 | RESET | <= 0;
84 | ERASE | <= 1;
85 | EXPOSE | <= 0;
86 | convert | <= 0;
87 | READ_RESET | <= 0;
88 | READ_CLK_IN | <= 0;
89 | end
90
91 | STATE_EXPOSE: begin
92 | POWER_ENABLE | <= 1;
93 | WRITE_ENABLE | <= 1;
94 | COUNTER_RESET | <= 0;
95 | RESET | <= 0;
96 | ERASE | <= 0;
97 | EXPOSE | <= 1;
98 | convert | <= 0;
99 | READ_RESET | <= 0;
100 | READ_CLK_IN | <= 0;
101 | end
102
103 | STATE_CONVERT: begin
104 | POWER_ENABLE | <= 1;
105 | WRITE_ENABLE | <= 1;
106 | COUNTER_RESET | <= 0;
107 | RESET | <= 0;
108 | ERASE | <= 0;
109 | EXPOSE | <= 0;
110 | convert | <= 1;
111 | READ_RESET | <= 0;
112 | READ_CLK_IN | <= 0;
113 | end
114
115 | STATE_READ: begin
116 | POWER_ENABLE | <= 1;
117 | WRITE_ENABLE | <= 0;
118 | COUNTER_RESET | <= 0;
119 | RESET | <= 0;
120 | ERASE | <= 0;
121 | EXPOSE | <= 0;
122 | convert | <= 0;
123 | READ_RESET | <= 0;
124 | READ_CLK_IN | <= 1;
125 | end
126
127 | STATE_IDLE: begin
128 | POWER_ENABLE | <= 0;
129 | WRITE_ENABLE | <= 0;
130 | COUNTER_RESET | <= 0;
131 | RESET | <= 0;
132 | ERASE | <= 0;
133 | EXPOSE | <= 0;
134 | convert | <= 0;
135 | READ_RESET | <= 0;
136 | READ_CLK_IN | <= 0;
137 | end
138
139 | endcase // case (state)
140 | end // always @ (state)
141
142
143 | // Control the state transitions
144 | always_ff @(posedge SYSTEM_CLK or posedge SYSTEM_RESET)
begin
145 | if(SYSTEM_RESET) begin
146 | state | = STATE_IDLE;
147 | next_state | = STATE_ERASE;
148 | counter | = 0;
149 | convert | = 0;
150 | end
151 | else begin
152 | case (state)
153 | STATE_ERASE: begin
154 | if(counter == c_erase) begin
155 | next_state | <= STATE_EXPOSE;
156 | state | <= STATE_IDLE;
157 | end
158 | end
159
160 | STATE_EXPOSE: begin
161 | if(counter == c_expose) begin
162 | next_state | <= STATE_CONVERT;
163 | state | <= STATE_IDLE;
164 | end
165 | end
166
167 | STATE_CONVERT: begin
168 | if(counter == c_convert) begin
169 | next_state | <= STATE_READ;
170 | state | <= STATE_IDLE;
171 | end
172 | end
173
174 | STATE_READ: begin
175 | if(counter == c_read) begin
176 | state | <= STATE_IDLE;
177 | next_state | <= STATE_ERASE;
178 | end
179 | end
180
181 | STATE_IDLE:
182 | state <= next_state;
183
184 | endcase // case (state)
185
186 | if(state == STATE_IDLE)
187 | counter = 0;
188 | else
189 | counter = counter + 1;
190
191 | end
192 | end // always @ (posedge clk or posedge reset)
193
194endmodule

APPENDIX G
SYSTEMVERILOG: PIXELARRAY.V

1
2module PIXEL_ARRAY(
3 | input logic POWER_ENABLE,
4 | input logic WRITE_ENABLE,
5 | input logic COUNTER_RESET,
6 | input logic COUNTER_CLOCK,
7 | input real | ANALOG_RAMP,
8 | input logic RESET, | // Reset voltage in paper
9 | input logic ERASE, | // Pixel reset in paper
10 | input logic EXPOSE, | // PG in paper
11 | input logic SYSTEM_CLK,
12 | input logic READ_RESET,
13 | input logic READ_CLK_IN,
14 | input logic VBN1,
15
16 | output logic DATA_OUT_CLK,
17 | output logic [OUTPUT_BUS_PIXEL_WIDTH*BIT_DEPTH-1:0]
DATA_OUT

19);
20 | parameter WIDTH = 2;
21 | parameter HEIGHT = 2;
22 | parameter OUTPUT_BUS_PIXEL_WIDTH = 2;
23 | parameter BIT_DEPTH = 8;
24 | parameter dv_pixel = 0.5;
25
26 | wire [BIT_DEPTH*WIDTH - 1:0] data;
27 | logic [BIT_DEPTH - 1:0] counter;
28 | logic read_clk_out;
29 | logic [$clog2(HEIGHT):0] memory_row;
30 | logic memory_read_enable;
31 | logic [HEIGHT-1: 0] row_select;
32
33 | PIXEL_ARRAY_COUNTER #(
34 | .BIT_DEPTH(BIT_DEPTH))
35 | pac1(
36 | .COUNTER_RESET(COUNTER_RESET),
37 | .COUNTER_CLOCK(COUNTER_CLOCK),
38 | .DATA(counter)
39 | );
40
41 | genvar i;
42 | generate
43 | for (i = 0; i < WIDTH; i = i + 1) begin
44 | assign data[BIT_DEPTH*(i+1) - 1:BIT_DEPTH*i] =
| WRITE_ENABLE ? counter : ’Z;
45 | end
46 | endgenerate
47
48 | PIXEL_ARRAY_MEMORY_CONTROLLER #(
49 | .HEIGHT(HEIGHT),
50 | .WIDTH(WIDTH),
51 | .OUTPUT_BUS_PIXEL_WIDTH(OUTPUT_BUS_PIXEL_WIDTH)
)
52 | pamc1(
53 | .SYSTEM_CLK(SYSTEM_CLK),
54 | .READ_RESET(READ_RESET),
55 | .READ_CLK_IN(READ_CLK_IN),
56 | .READ_CLK_OUT(read_clk_out),
57 | .WRITE_CLK_OUT(DATA_OUT_CLK),
58 | .MEMORY_ROW(memory_row),
59 | .MEMORY_READ_ENABLE(memory_read_enable)
60 | );
61
62 | PIXEL_ARRAY_READ_POINTER #(
63 | .HEIGHT(HEIGHT))
64 | parp1 (
65 | .CONTROL(memory_row),
66 | .ENABLE(memory_read_enable),
67 | .ROW_SELECT(row_select)
68 | );
69
70 | PIXEL_ARRAY_BUS #(
71 | .BIT_DEPTH(BIT_DEPTH),
72 | .OUTPUT_BUS_PIXEL_WIDTH(OUTPUT_BUS_PIXEL_WIDTH)
,
73 | .WIDTH(WIDTH))
74 | pab1(
75 | .DATA(data),
76 | .READ_CLK(read_clk_out),
77 | .OUT(DATA_OUT),
78 | .WRITE_CLK(DATA_OUT_CLK)
79 | );
80
81
82 | // Pixels
83 | genvar column;
84 | genvar row;
85 | generate
86 | for(column = 0; column < WIDTH; column = column +
1)begin
87 | for(row = 0; row < HEIGHT; row = row + 1)begin
88 | PIXEL_SENSOR #(
89 | .BIT_DEPTH(BIT_DEPTH),
90 | .dv_pixel(dv_pixel))
91 | ps(
92 | .VBN1(VBN1),
93 | .RAMP(ANALOG_RAMP),
94 | .RESET(RESET), | // Reset
| voltage in paper
95 | .ERASE(ERASE), | // Pixel
| reset in paper
96 | .EXPOSE(EXPOSE), | // PG in
| paper
97 | .READ(row_select[row]), // Read in
| paper
98 | .DATA(data[BIT_DEPTH*(column+1)-1:
| BIT_DEPTH*(column)])
99 | );
100 | end
101 | end
102 | endgenerate
103
104endmodule

APPENDIX H
SYSTEMVERILOG: PIXELSENSOR.V

1
2//
3// | Copyright (c) 2021 Carsten Wulff Software, Norway
4//
5// Created | : wulff at 2021-7-21
6//
7// The MIT License (MIT)
8//
9// Permission is hereby granted, free of charge, to any person obtaining a copy
10// of this software and associated documentation files ( the "Software"), to deal
11// in the Software without restriction, including without limitation the rights
12// to use, copy, modify, merge, publish, distribute, sublicense, and/or sell
13// copies of the Software, and to permit persons to whom the Software is
14// furnished to do so, subject to the following conditions :
15//
16// The above copyright notice and this permission notice shall be included in all
17// copies or substantial portions of the Software. 18//
19// THE SOFTWARE IS PROVIDED "AS IS", WITHOUT WARRANTY OF ANY KIND, EXPRESS OR
20// IMPLIED, INCLUDING BUT NOT LIMITED TO THE WARRANTIES OF MERCHANTABILITY,
21// FITNESS FOR A PARTICULAR PURPOSE AND NONINFRINGEMENT. IN NO EVENT SHALL THE
22// AUTHORS OR COPYRIGHT HOLDERS BE LIABLE FOR ANY CLAIM, DAMAGES OR OTHER
23// LIABILITY, WHETHER IN AN ACTION OF CONTRACT, TORT OR OTHERWISE, ARISING FROM,
24// OUT OF OR IN CONNECTION WITH THE SOFTWARE OR THE USE OR OTHER DEALINGS IN THE
25// SOFTWARE.
26//
27//
28
29//
30// Model of pixel sensor, including
31// | - Reset
32// | - The sensor
33// | - Comparator
34// | - Memory latch
35// | - Readout of latched value
36//
37module PIXEL_SENSOR
38 | (
39 | input logic | VBN1, | // Amount of posedges
decides how low photodiode is
40 | input logic | RAMP,
41 | input logic | RESET, | // Reset voltage in paper,
this variable is not used
42 | input logic | ERASE, | // Pixel reset in paper
43 | input logic | EXPOSE, | // PG in paper
44 | input logic | READ, | // Read in paper
45 | inout [BIT_DEPTH - 1:0] DATA
46
47 );
48
49 parameter integer BIT_DEPTH = 8;
50
51 | real | v_erase | = 1.1;
52 | real | v_min | = 0.5;
53 | real | lsb | = (v_erase-v_min)/(2**
| BIT_DEPTH);

54 | real | lsb_expose | = (v_erase-v_min)/(2**
| BIT_DEPTH);
55 | parameter real | dv_pixel | = 0.8;
56
57 | real | tmp;
58 | logic | cmp;
59 | real | adc;
60
61 | logic [BIT_DEPTH - 1:0] | p_data;
62
63 | //
64 | // ERASE
65 | //
66 | // Reset the pixel value on pixRst
67 | always @(ERASE) begin
68 | tmp = v_erase;
69 | p_data = 0;
70 | cmp | = 1;
71 | adc = v_min;
72 | end
73
74 | //
75 | // SENSOR
76 | //
77 | // Use bias to provide a clock for integration when
| exposing
78 | always @(posedge VBN1) begin
79 | if(EXPOSE)
80 | tmp = tmp - dv_pixel*lsb_expose;
81 | end
82
83 | //
84 | // Comparator
85 | //
86 | // Use ramp to provide a clock for ADC conversion,
assume that ramp
87 | // and DATA are synchronous
88 | always @(posedge RAMP) begin
89 | adc = adc + lsb;
90 | if(adc > tmp)
91 | cmp <= 0;
92 | end
93
94 | //
95 | // Memory latch
96 | //
97 | always_comb | begin
98 | if(cmp) begin
99 | p_data = DATA;
100 | end
101 | end
102
103 | //
104 | // Readout
105 | //
106 | // Assign data to bus when pixRead = 1
107 | // The readout of the memory inverts the data
108 | assign DATA = READ ? ˜p_data : ’Z;
109
110endmodule // re_control

APPENDIX I
SYSTEMVERILOG: PIXELARRAYCOUNTER.V

1
2
3module PIXEL_ARRAY_COUNTER (
4 | input | logic COUNTER_RESET,
5 | input | logic COUNTER_CLOCK,
6 | output | logic [BIT_DEPTH - 1:0] DATA
7);
8
9 | parameter BIT_DEPTH = 10;
10
11 | logic [BIT_DEPTH - 1:0] counter = ’0;
12
13 | always_ff @(posedge COUNTER_CLOCK or posedge
COUNTER_RESET) begin
14 | if (COUNTER_RESET) begin
15 | | counter <= 0;
16 | end else begin
17 | | counter <= counter + 1;
18 | end
20 | // Gray-coding the counter
21 | DATA[BIT_DEPTH-1] | <= counter[BIT_DEPTH-1];
22 | DATA[BIT_DEPTH-2:0] <= counter[BIT_DEPTH-1:1] ˆ
counter[BIT_DEPTH-2:0];
23 | end
24
25endmodule

APPENDIX J
SYSTEMVERILOG: PIXELARRAYMEMORYCONTROLLER.V

1
2module PIXEL_ARRAY_MEMORY_CONTROLLER (
3 | input | logic SYSTEM_CLK,
4 | input | logic READ_RESET,
5 | input | logic READ_CLK_IN,
6 | output | logic READ_CLK_OUT = 0,
7 | output | logic WRITE_CLK_OUT,
8 | output | logic [$clog2(HEIGHT):0] MEMORY_ROW = -1,
9 | output | logic MEMORY_READ_ENABLE = 0
10);
11
12 | parameter integer WIDTH = 2;
13 | parameter integer HEIGHT = 2;
14 | parameter integer OUTPUT_BUS_PIXEL_WIDTH = 2; // Needs
to go up in WIDTH
15
16
17 | parameter integer POINT_TO_ROW = 0, READ_TO_BUFFER = 1,
WRITE_OUT = 2, DONE = 3;
18
19 | logic control_clk;
20 | logic [1:0] state | = DONE;
21 | logic state_enable | = 0;
22 | logic write_out_enable | = 0;
23
24 | logic [$clog2(WIDTH):0] write_number = 0;
25
26 | always_ff @(posedge READ_CLK_IN) begin
27 | state_enable | <= 1;
28 | state | <= 0;
29 | MEMORY_READ_ENABLE | <= 1;
30 | MEMORY_ROW | = -1;
31 | end
32
33 | assign control_clk | = state_enable | ? SYSTEM_CLK | :
| 0;
34 | assign WRITE_CLK_OUT = write_out_enable ? control_clk :
| 0;
35
36 | always_ff @(posedge control_clk) begin
37
38 | case (state)
39 | POINT_TO_ROW:
40 | begin
41 | write_out_enable | <= 0;
42 | MEMORY_ROW | <= MEMORY_ROW + 1;
43 | state | <= READ_TO_BUFFER;
44 | end
45
46 | READ_TO_BUFFER:
47 | begin
48 | READ_CLK_OUT | <= 1;
49 | state | <= WRITE_OUT;
50 | write_number | <= 0;
51 | end
52
53 | WRITE_OUT:
54 | begin
55 | READ_CLK_OUT | <= 0;
56 | write_out_enable | <= 1;
57 | write_number | <= write_number +
| | 1;
58
59 | if (write_number == WIDTH/
OUTPUT_BUS_PIXEL_WIDTH - 1) begin
60 | state <= (MEMORY_ROW == HEIGHT - 1)
? DONE : POINT_TO_ROW;
61 | end
62 | end
63
64 | DONE:
65 | begin
66 | MEMORY_READ_ENABLE | <= 0;

67 | MEMORY_ROW | <= -1;
68 | state_enable | <= 0;
69 | end
70
71 | default:
72 | begin
73 | end
74 | endcase
75
76 | end
77
78endmodule

APPENDIX K
SYSTEMVERILOG: PIXELARRAYREADPOINTER.V

1
2module PIXEL_ARRAY_READ_POINTER (
3 | input | logic [$clog2(HEIGHT):0] CONTROL,
4 | input | logic ENABLE,
5 | output | logic [HEIGHT-1:0] ROW_SELECT
6);
7
8parameter integer HEIGHT = 2;
9
10assign ROW_SELECT = ENABLE ? (1 << CONTROL) : ’0; 11
12endmodule

APPENDIX L
SYSTEMVERILOG: PIXELARRAYBUS.V

1
2module PIXEL_ARRAY_BUS (
3 | input | logic [WIDTH*BIT_DEPTH-1:0] DATA,
4 | input | logic READ_CLK,
5 | input | logic WRITE_CLK,
6 | output | logic [OUTPUT_BUS_PIXEL_WIDTH*BIT_DEPTH-1:0]
| OUT
7);
8
9 | parameter integer BIT_DEPTH = 8;
10 | parameter integer OUTPUT_BUS_PIXEL_WIDTH = 2;
11 | parameter integer WIDTH = 2;
12 | logic [WIDTH*BIT_DEPTH-1:0] buffer = ’0;
13 | logic [OUTPUT_BUS_PIXEL_WIDTH*BIT_DEPTH-1:0] converted;
14
15
16 | // Reads data from one row into the buffer
17 | always_ff @(posedge READ_CLK) begin
18 | buffer <= ˜DATA; // Data is inverted back after it
| | has been inverted by the pixel-memory
19 | end
20
21
22
23 | // Shift register: Sequences data to be written out
| | of the system
24 | genvar i;
25 | generate for(i = 0; i < WIDTH/OUTPUT_BUS_PIXEL_WIDTH-1;
i++) begin
26 | | always_ff @(posedge WRITE_CLK) begin
27 | | buffer[BIT_DEPTH*OUTPUT_BUS_PIXEL_WIDTH*(i
| | +1)-1:BIT_DEPTH*OUTPUT_BUS_PIXEL_WIDTH*
| | i] <= buffer[BIT_DEPTH*
| | OUTPUT_BUS_PIXEL_WIDTH*(i+2)-1:
| | BIT_DEPTH*OUTPUT_BUS_PIXEL_WIDTH*(i+1)
| | ];
28 | | end
29 | end
30 | endgenerate
31
32 | always_ff @(posedge WRITE_CLK) begin
33 | buffer[WIDTH*BIT_DEPTH-1:WIDTH*BIT_DEPTH-
| | OUTPUT_BUS_PIXEL_WIDTH*BIT_DEPTH] <= ’0;
34 | end
35
36
38 | // Gray decoder: Turns Gray coded data from the end
| | of the shift register into regular binary
39 | genvar pixel;
40 | genvar index;
41 | generate
42
43 | for (pixel = 1; pixel < OUTPUT_BUS_PIXEL_WIDTH+1;
| pixel++) begin
44 | assign converted[pixel*BIT_DEPTH-1] = buffer[
| pixel*BIT_DEPTH-1];
45
46 | for (index = 2; index < BIT_DEPTH+1; index++)
| begin
47 | assign converted[pixel*BIT_DEPTH - index] =
| converted[pixel*BIT_DEPTH - index+1] ˆ
| buffer[pixel*BIT_DEPTH - index];
48 | end
49 | end
50
51 | endgenerate
52
53
54
55 | // Writes data to output
56 | always_ff @(posedge WRITE_CLK) begin
57 | OUT <= converted;
58 | end
59
60
61endmodule

REFERENCES

[1] Y. Oike, K. Akiyama, L. D. Hung, W. Niitsuma, A. Kato, M. Sato,
Y. Kato, W. Nakamura, H. Shiroshita, Y. Sakano, Y. Kitano, T. Nakamura,
T. Toyama, H. Iwamoto, and T. Ezaki, “An 8.3m-pixel 480fps global-shutter cmos image sensor with gain-adaptive column adcs and 2-on-1 stacked device structure,” in 2016 IEEE Symposium on VLSI Circuits (VLSI-Circuits), 2016, pp. 1–2.
[2] S. Kleinfelder, S. Lim, X. Liu, and A. E. Gamal, “A 10 000 frames/s cmos digital pixel sensor,” JSSC, vol. 36, no. 12, pp. 2049–2059, 2001.
[3] C. Liu, L. Bainbridge, A. Berkovich, S. Chen, W. Gao, T.-H. Tsai,
K. Mori, R. Ikeno, M. Uno, T. Isozaki, Y.-L. Tsai, I. Takayanagi, and
J. Nakamura, “A 4.6m, 512×512, ultra-low power stacked digital pixel sensor with triple quantization and 127db dynamic range,” in 2020 IEEE International Electron Devices Meeting (IEDM), 2020, pp. 16.1.1–16.1.4.
[4] C. Wulff. (2021) Dicex (design of integrated circuits examples). [Online]. Available: https://github.com/wulffern/dicex
