DanielVorhaug/TFE4152-Project--Digital-Pixel-Sensor/verilog/pixelArrayBus.v

module PIXEL_ARRAY_BUS (
    input   logic [WIDTH*BIT_DEPTH-1:0] DATA,
    input   logic READ_CLK,
    input   logic WRITE_CLK,
    output  logic [OUTPUT_BUS_PIXEL_WIDTH*BIT_DEPTH-1:0] OUT
);

    parameter integer BIT_DEPTH = 8;
    parameter integer OUTPUT_BUS_PIXEL_WIDTH = 2;
    parameter integer WIDTH = 2;
    logic [WIDTH*BIT_DEPTH-1:0] buffer = '0;
    logic [OUTPUT_BUS_PIXEL_WIDTH*BIT_DEPTH-1:0] converted;


        // Reads data from one row into the buffer
    always_ff @(posedge READ_CLK) begin
        buffer <= ~DATA; // Data is inverted back after it has been inverted by the pixel-memory
    end



        // Shift register: Sequences data to be written out of the system
    genvar i;
    generate for(i = 0; i < WIDTH/OUTPUT_BUS_PIXEL_WIDTH-1; i++) begin
            always_ff @(posedge WRITE_CLK) begin
                buffer[BIT_DEPTH*OUTPUT_BUS_PIXEL_WIDTH*(i+1)-1:BIT_DEPTH*OUTPUT_BUS_PIXEL_WIDTH*i] <= buffer[BIT_DEPTH*OUTPUT_BUS_PIXEL_WIDTH*(i+2)-1:BIT_DEPTH*OUTPUT_BUS_PIXEL_WIDTH*(i+1)];
            end
        end
    endgenerate

    always_ff @(posedge WRITE_CLK) begin
        buffer[WIDTH*BIT_DEPTH-1:WIDTH*BIT_DEPTH-OUTPUT_BUS_PIXEL_WIDTH*BIT_DEPTH] <= '0;
    end



        // Gray decoder: Turns Gray coded data from the end of the shift register into regular binary
    genvar pixel;
    genvar index;
    generate
        
        for (pixel = 1; pixel < OUTPUT_BUS_PIXEL_WIDTH+1; pixel++) begin
            assign converted[pixel*BIT_DEPTH-1] = buffer[pixel*BIT_DEPTH-1];

            for (index = 2; index < BIT_DEPTH+1; index++) begin
                assign converted[pixel*BIT_DEPTH - index] = converted[pixel*BIT_DEPTH - index+1] ^ buffer[pixel*BIT_DEPTH - index];
            end
        end
        
    endgenerate



        // Writes data to output
    always_ff @(posedge WRITE_CLK) begin
        OUT <= converted;
    end


endmodule
