DanielVorhaug/TFE4152-Project--Digital-Pixel-Sensor/(commit log)

2021-10-04 Test counter with reset
    [pixelArray_tb.v]
2021-10-04 Made DATA a wire again
2021-10-15 Simulation dumpfile, correct name
    [pixelArrayBus_tb.v, pixelArrayCounter_tb.v, pixelArrayMemoryController_tb.v, pixelArrayReadPointer_tb.v]
2021-10-15 Not init variable value
    Caused problems
    [pixelArrayBus_tb.v, pixelArrayCounter_tb.v]
2021-10-25 Fixed naming and initiation of variables
    [pixelArray_tb.v]
2021-10-25 Changed the clock to the counter
    Needed for correct conversion of pixel data
    [pixelArray_tb.v]
2021-10-25 Reading pixel sensor working
2021-10-29 Start recording before reset
    [pixelTop_tb.v]
2021-11-05 Made switches transistor based
    Also made an inverter needed for the purpose
2021-11-05 Fixed naming error in switches
2021-11-09 Fixed bugs related to modularity
    [pixelState.v, pixelTop_tb.v]
2021-11-09 Correct sensor memory size
    [pixelSensor.v]
2021-11-17 Lowered the current budget
2021-11-18 Inverting memory readout and inverting back
    [pixelArrayBus.v, pixelSensor.v]
2021-11-18 Make ramp go from 0.5V to 1.1V
    instead of 0.5V to 1.4V
2021-11-18 Match analog model voltages
